PRAMOTH-S/nexvac/src/nexva_description/meshes/lidar_1.stl

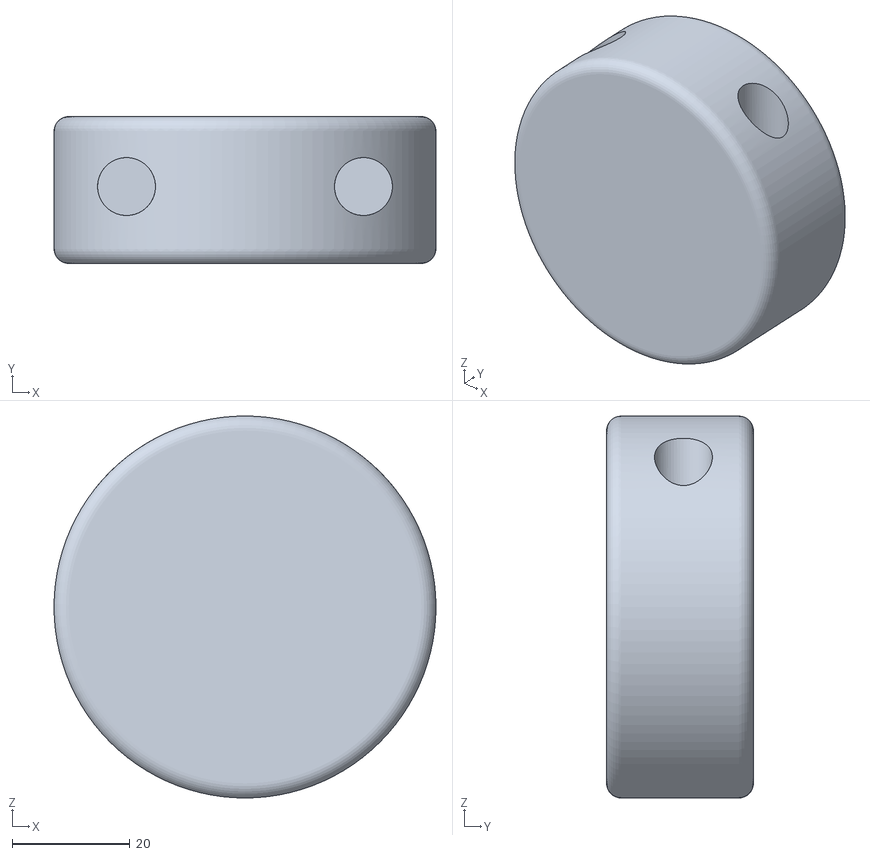
[picture p1: CAD file, 2026-09-10]
src/nexva_description/meshes/lidar_1.stl
65.0 x 25.0 x 65.0
