PRAMOTH-S/nexvac/src/nexva_description/meshes/right_wheel_1.stl

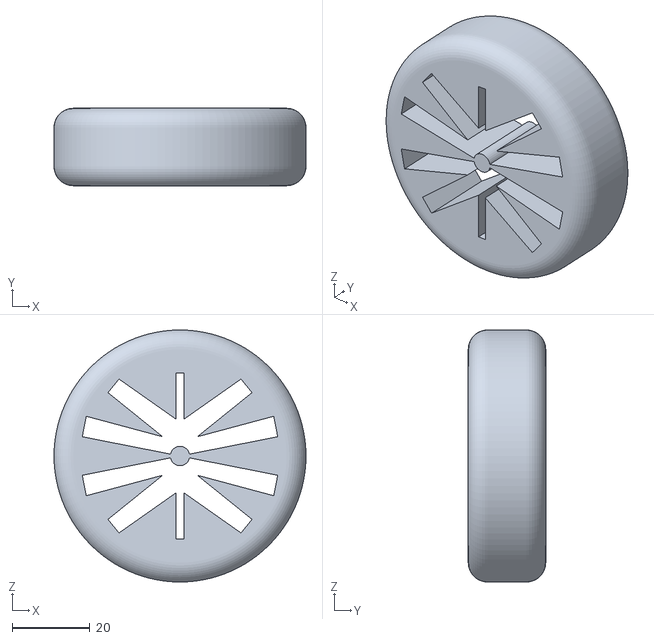
[picture p2: CAD file, 2026-09-10]
src/nexva_description/meshes/right_wheel_1.stl
65.0 x 20.0 x 65.0
