PRAMOTH-S/nexvac/src/nexva_description/meshes/base_link.stl

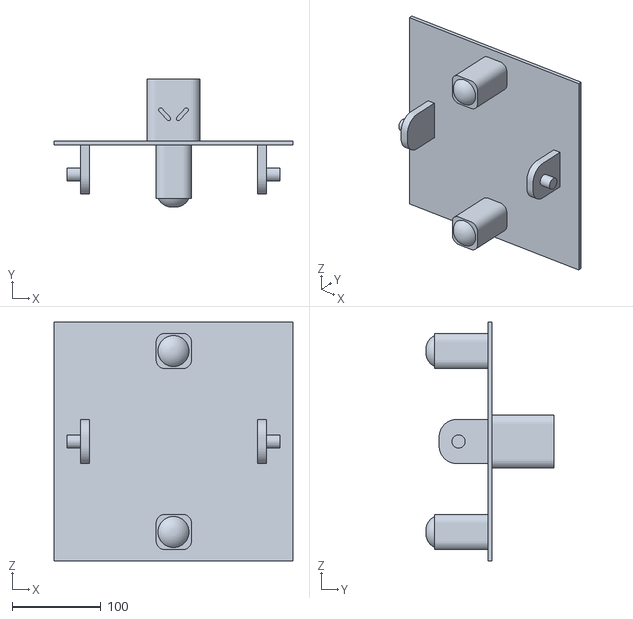
[picture p3: CAD file, 2026-09-10]
src/nexva_description/meshes/base_link.stl
270.0 x 145.0 x 270.0
