PRAMOTH-S/nexvac/(commit log)

2026-09-10 Initial Nexva ROS2 workspace
    [base_link.stl, left_wheel_1.stl, lidar_1.stl, materials.xacro, nexva.urdf.xacro, right_wheel_1.stl, vacuum_world.sdf]
2026-09-16 Agent Restart is working no need to press the reset button
2026-09-16 NO delay in odom with lidar, joint is publishing but direction is wrong - before break
    [nexva.urdf.xacro]
2026-09-16 urdf tf is working
    [nexva.urdf.xacro]
2026-09-16 robot model
    [nexva.urdf.xacro]
2026-09-28 Nithanam Code with PID
2026-10-07 L/R Wheel ui
